EVA-3D/led-shrouds/readme.md

# EVA 2 / LED Shroud

This is just a EVA submodule. Navigate to EVA 2 / Main:

Repository: https://github.com/EVA-3D/eva-main
Dosc: https://eva-3d.github.io/eva-main/
