EVA-3D/led-shrouds/assets/universal_led_shroud.png

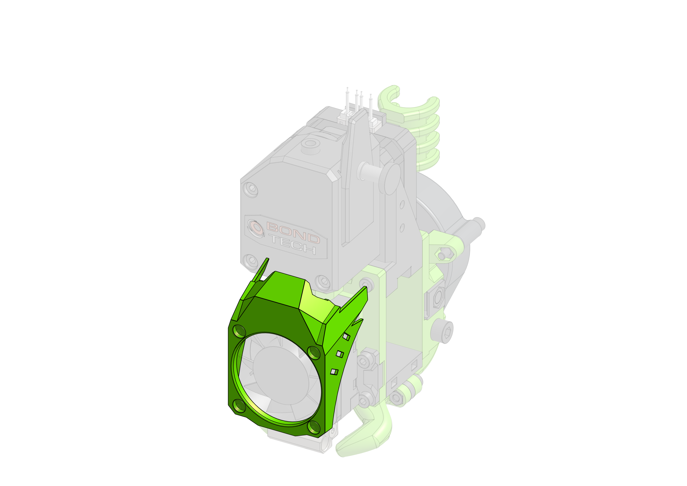
assets/universal_led_shroud.png
