EVA-3D/led-shrouds/bom/magnetic.csv

Item | Quantity | Name | Material
1 | 1 | shroud_magnetic | PETG
2 | 1 | Neopixel Flora v2 | - None -
3 | 1 | led holder | PETG
