EVA-3D/led-shrouds/bom/regular.csv

Item | Quantity | Name | Material
1 | 1 | shroud | PETG
2 | 1 | Neopixel Flora v2 | - None -
3 | 1 | led holder | PETG
