EVA-3D/led-shrouds/stls/led_holder.stl

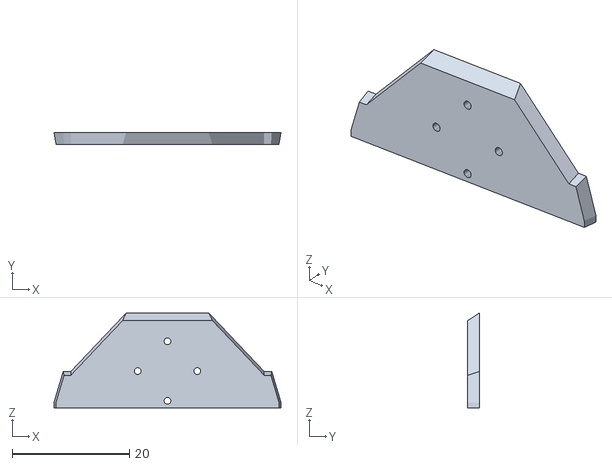
[picture p5: CAD file, 2021-03-28]
stls/led_holder.stl
38.7 x 2.00 x 16.2
