EVA-3D/led-shrouds/stls/shroud.stl

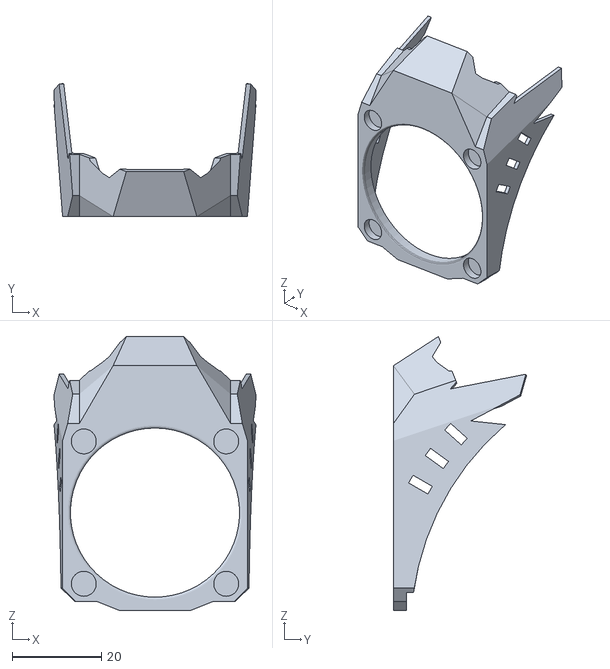
[picture p6: CAD file, 2021-03-28]
stls/shroud.stl
45.4 x 29.9 x 61.6
