EVA-3D/led-shrouds/(commit log)

2021-03-28 add LED shroud with Klipper config
    [magnetic.csv, regular.csv]
2021-03-28 add missing STL files
    [led_holder.stl, shroud.stl]
2021-03-29 add wiring for SKR GTR and SKR V1.4
